lm2-poly/PCF_Setup_Article/BOM_Article.xlsx

Name | Description | Number | Unity price | Total price | Link
Sub-assembly: Flowmeter group
Rosemount 8711TSA010T1N0 flowmeter | Magnetic flowtube salvaged on an older experimental setup. Any other flowtube can work as well depending on your setup scale and precision needs | 1 | 2200 | 2200 | See with your local Rosemount products supplier
Rosemount 8732CT12N0M4 transmitter | Transmitter assembled with the flowtube to read the flowrate and give an output current signal from 4 to 20mA. Any alternative compatible with your flowtube can be considered | 1 | 2800 | 2800 | See with your local Rosemount products supplier
Steel corner brackets 1845A34 | Steel corners to be machined to fix the flowmeter on the wall | 2 | 30.03 | 60.06 | https://www.mcmaster.com/1845A34/
Threaded rods 96545A235 | Threaded rods used to fix the flowmeter between the flanges | 4 | 9.58 | 38.32 | https://www.mcmaster.com/96545A235/
Washers 98017A215 | Washers used to fix the flowmeter between the flanges (pack of 25) | 1 | 17.37 | 17.37 | https://www.mcmaster.com/98017A215/
Nuts 95462A533 | Nuts used to fix the flowmeter between the flanges (pack of 25) | 1 | 14.26 | 14.26 | https://www.mcmaster.com/95462A533/
Flange 43505K353 | Flange used to fix the flowmeter | 2 | 48.65 | 97.3 | https://www.mcmaster.com/43505K353/
Rubber gasket 1082N11 | Gasket used between the flowmeter and the flanges to achieve sealing | 2 | 2.06 | 4.12 | https://www.mcmaster.com/1082N11/
Barbed fitting 5361K46 | Barbed fitting used to connect the flowmeter to the flexible hoses of the circuit | 2 | 26.4 | 52.8 | https://www.mcmaster.com/5361K46/
Sub-assembly: Secondary tank
Secondary tank 3669K27 | Pressure rated tank used to attenuate fluctuation in the flow after the pump | 1 | 381.4 | 381.4 | https://www.mcmaster.com/3669K27/
Heavy shelf brackets 2736A723 | Brackets used to support the tank on the wall | 2 | 18.84 | 37.68 | https://www.mcmaster.com/2736A723/
Clamp 3116T75 | Clamp used to maintain the tank to the wall | 1 | 234.26 | 234.26 | https://www.mcmaster.com/3116T75/
Wood plank 1125T421 | Wood plank used to support the tank on the shelf brackets | 1 | 50.83 | 50.83 | https://www.mcmaster.com/1125T421/
Pressure relieve valve 4780K13-4780K86 | Relieve valve to avoid pressures above 75psi in the circuit | 1 | 165.23 | 165.23 | https://www.mcmaster.com/4780K13-4780K86/
Barbed fitting 5361K46 | Barbed fitting used to connect the secondary tank to the flexible hoses of the circuit | 2 | 26.4 | 52.8 | https://www.mcmaster.com/5361K46/
Plug 1" 4464K256 | Plug used to block the unused outputs/inputs of the secondary tank | 2 | 10.54 | 21.08 | https://www.mcmaster.com/4464K256/
Plug 1 1/4" 4464K257 | Plug used to block the unused outputs/inputs of the secondary tank | 1 | 17.06 | 17.06 | https://www.mcmaster.com/4464K257/
Plug 1/2" 4464K254 | Plug used to block the unused outputs/inputs of the secondary tank | 1 | 4.88 | 4.88 | https://www.mcmaster.com/4464K254/
Screws 92949A251 | Screws used for the fixation of the wood plank on the brackets (pack of 50) | 1 | 11.59 | 11.59 | https://www.mcmaster.com/92949A251/
Washers 92141A011 | Washers used for the fixation of the wood plank on the brackets (pack of 100) | 1 | 2.4 | 2.4 | https://www.mcmaster.com/92141A011/
Nuts 91841A011 | Nuts used for the fixation of the wood plank on the brackets (pack of 100) | 1 | 5.35 | 5.35 | https://www.mcmaster.com/91841A011/
Sub-assembly: Pump group
Baldor M3559 motor | 3HP, 3450RPM, 60Hz, 208-230V single phase motor used to drive the pump. This motor was salvaged on an old experimental setup and is not sold anymore. Any alternative providing enough power for the needed flowrate and compatible with the reader electrical instalation and pump is to be considered | 1 | NA | NA | https://www.baldor.com/catalog/M3559
Price Pump Model OH75 | Centrifugal pump mounted on the Baldor motor. This pump is also not in sale anymore and the reader can chose any pump corresponding to his needs and compatible with its motor | 1 | NA | NA | https://www.price-pumpen.de/oh75-series.html
Siemens Sinamics V20 drive | Electrical drive used to control the motor of the pump. This drive was chosen to correspond to our motor and our electrical installation. The reader shall chose his trio motor, pump and drive | 1 | 380 | 380 | See with your local Siemens supplier
Union connector 4464K487 | Union threaded connector used to disconnect the output of the pump easily | 1 | 23.7 | 23.7 | https://www.mcmaster.com/4464K487/
Union connector 4464K488 | Union threaded connector used to disconnect the input of the pump easily | 1 | 35.66 | 35.66 | https://www.mcmaster.com/4464K488/
Stainless steel pipe 4830K196 | Pipe used to connect the output of the pump to the flow control valve | 1 | 10.11 | 10.11 | https://www.mcmaster.com/4830K196/
Flow control valve 4742K14 | Valve added at the output of the pump to control the flowrate more precisely if needed | 1 | 92.75 | 92.75 | https://www.mcmaster.com/4742K14/
Barbe fitting 5361K45 | Barbed fitting used to connect the output of the pump to the flexible hoses of the circuit | 1 | 16.24 | 16.24 | https://www.mcmaster.com/5361K45/
Barbe fitting 5361K48 | Barbed fitting used to connect the input of the pump to the flexible hoses of the circuit | 1 | 23.84 | 23.84 | https://www.mcmaster.com/5361K48/
Sub-assembly: Main tank
Main plastic tank 3764K31 | Main 30USG plastic tank used to store the water of the system | 1 | 690 | 690 | https://www.mcmaster.com/3764K31/
Plastic pipe 9173K75 | Pipe connected to the output of the main tank | 1 | 4.96 | 4.96 | https://www.mcmaster.com/9173K75/
Plastic to stainless steel pipe adapter 4596K287 | Part used to connect the plastic part of the tank to the stainless circuit | 1 | 222.27 | 222.27 | https://www.mcmaster.com/4596K287/
Stainless steel pipe 4830K226 | Pipe connected to the output of the main tank before the On/Off valve | 1 | 13.32 | 13.32 | https://www.mcmaster.com/4830K226/
On/Off valve 4629K15 | Valve after the tank to close the ouput of the tank if needed | 1 | 33.8 | 33.8 | https://www.mcmaster.com/4629K15/
Barbe fitting 5361K48 | Barbed fitting used to connect the output of the main tank to the flexible hoses of the circuit | 1 | 23.84 | 23.84 | https://www.mcmaster.com/5361K48/
Sub-assembly: Acrylic tank
Wall acrylic sheets 8560K435 | Translucid side plates of the tank | 4 | 105.64 | 422.56 | https://www.mcmaster.com/8560K435/
Bottom acrylic sheet 8560K272 | Bottom plate of the tank | 1 | 354.97 | 354.97 | https://www.mcmaster.com/8560K272/
Bottom wood plank 1125T614 | Wood plank added to the acrylic bottom sheet to improve rigidity and facilitate assembly of the tank | 1 | 54.15 | 54.15 | https://www.mcmaster.com/1125T614/
Middle drain 36895K156 | Drain in the middle of the tank to evacuate the water coming from the pipe conveying fluid | 1 | 74.7 | 74.7 | https://www.mcmaster.com/36895K156/
Corner aluminium part 8144A33 | Corners fixed on each corner of the acrylic tank to improve rigidity and avoid leaks. The parts have to be cut in half to have the 2 feets hight of the tank | 2 | 55.12 | 110.24 | https://www.mcmaster.com/8144A33/
Sub-assembly: Acrylic tank support
Aluminium T-slotted extrusion 47065T102-47065T602 | Aluminium extrusions used to build the structure to support the acrylic tank | 14 | 27.58 | 386.12 | https://www.mcmaster.com/47065T102-47065T602/
Corner fixations 47065T241 | Corners used to fix the extrusions together (sold with screws) | 20 | 9.54 | 190.8 | https://www.mcmaster.com/47065T241/
Floor mounting 3136N146 | Mountings used to fix the extrusions on the floor of the lab (sold with screws) | 4 | 63.97 | 255.88 | https://www.mcmaster.com/3136N146/
Sub-assembly: Pipes from the acrylic to the main tank and tubing
PVC Pipe 4882K88 | Plastic pipe connected to the drain of the acrylic tank | 1 | 15.07 | 15.07 | https://www.mcmaster.com/4882K88/
PVC elbows 4880K174 | Plastic elbows used for the tubing between the acrylic tank and the main tank | 2 | 16.48 | 32.96 | https://www.mcmaster.com/4880K174/
PVC Pipe 6810K618 | Plastic pipe used for the tubing between the acrylic tank and the main tank | 1 | 66.67 | 66.67 | https://www.mcmaster.com/6810K618/
PVC Pipe 6810K47 | Plastic pipe used for the tubing between the acrylic tank and the main tank | 1 | 37.01 | 37.01 | https://www.mcmaster.com/6810K47/
On/Off valve 2772T95 | Valve used to close the output of the acrylic tank | 1 | 24.42 | 24.42 | https://www.mcmaster.com/2772T95/
Strut channel 3188T3-3188T23 | Structure fixed to the wall and used to maintain the piping between the acrylic tank and the main tank | 1 | 25.56 | 25.56 | https://www.mcmaster.com/3188T3-3188T23/
Pipe clamp 3006T83 | Hanging pipe clamp fixed on the previous strut channel to clamp the pipe from the acrylic tank to the main tank | 1 | 27.96 | 27.96 | https://www.mcmaster.com/3006T83/
Flexible hose 5632K36 | 3/4" and 5ft long hoses used to connect the secondary tank to the flowmeter and the flowmeter to the pipe conveying fluid | 2 | 9.8 | 19.6 | https://www.mcmaster.com/5632K36/
Flexible hose 5632K36 | 3/4" and 10ft long hose used to connect the output of the pump to the secondary tank | 1 | 15.6 | 15.6 | https://www.mcmaster.com/5632K36/
Flexible hose 52375K17 | 1" and 5ft long hose used to connect the main tank to the input of the pump | 1 | 18.05 | 18.05 | https://www.mcmaster.com/52375K17/
Worm drive clamp 5388K16 | Worm drive clamp used to clamp the pipe conveying fluid on the barbe fitting (pack of 10) | 1 | 10.02 | 10.02 | https://www.mcmaster.com/5388K16/
Worm drive clamp 5388K22 | Worm drive clamp used to clamp the 1" flexible hoses on the barbe fittings (pack of 10) | 1 | 12.57 | 12.57 | https://www.mcmaster.com/5388K22/
Worm drive clamp 5388K17 | Worm drive clamp used to clamp the 3/4" flexible hoses on the barbe fittings (pack of 10) | 1 | 11 | 11 | https://www.mcmaster.com/5388K17/
Sub-assembly: Cameras
BFS-U3-20S4C-C Camera | USB3 cameras used to film the pipe from 2 directions at relatively high FPS | 2 | 825 | 1650 | See with your local camera supplier
FL-CC0814-2M Lens | 6mm lenses mounted on the cameras | 2 | 135 | 270 | See with your local camera supplier
ACC-01-2301 USB cable | Cables used to connect the cameras to a laptop | 2 | 33 | 66 | See with your local camera supplier
ACC-01-3009 GPIO cable | GPIO cables used to control (synchronize) the cameras with voltage signals | 2 | 38 | 76 | See with your local camera supplier
ACC-01-0016 mounting plate | Tripod mounting plate used to fix the cameras | 2 | 33 | 66 | See with your local camera supplier
Aluminium T-Slotted extrusion 47065T101-47065T412 | Aluminium rails used to fix the camera and to be able to adjust their positions in 2 dimensions | 2 | 16.65 | 33.3 | https://www.mcmaster.com/47065T101-47065T412/
Corner brackets 2313N47 | Corner screwed on the rails to support the cameras | 2 | 13.39 | 26.78 | https://www.mcmaster.com/2313N47/
Corner fixations 47065T236 | Corner used to fix the 3D printed parts on the aluminium extrusions (sold with screws) | 10 | 7.92 | 79.2 | https://www.mcmaster.com/47065T236/
Screws 91290A195 | Screws used to fix the previous corners on the 3D printed parts (pack of 10) | 1 | 7.67 | 7.67 | https://www.mcmaster.com/91290A195/
Nuts 90591A260 | Nuts used to fix the previous corners on the 3D printed parts (pack of 100) | 1 | 3.56 | 3.56 | https://www.mcmaster.com/90591A260/
Washers 93475A240 | Washers used to fix the previous corners on the 3D printed parts (pack of 100) | 1 | 3.52 | 3.52 | https://www.mcmaster.com/93475A240/
T-slot nuts 94750A591 | Nuts used to clamp the bottom 3D printed parts on the bottom edge of the tank | 4 | 8.16 | 32.64 | https://www.mcmaster.com/94750A591/
Screws 91251A846 | Screws used to clamp the bottom edge of the tank with the previous T-slotted nuts | 4 | 4.8 | 19.2 | https://www.mcmaster.com/91251A846/
Top 3D printed part CameraFixTop | 3D printed part clamped on the top of the acylic tank and maintaining the aluminium T-slotted extrusion | 2 | NA | NA | See the design files summary
Bottom 3D printed part CameraFixBot | 3D printed part clamped on the bottom edge of the acylic tank and maintaining the aluminium T-slotted extrusion | 2 | NA | NA | See the design files summary
T-slotted inserts fixations 47065T215 | Fixations used to fix the cameras corners to the aluminium T-slotted rails (pack of 4) | 1 | 3.56 | 3.56 | https://www.mcmaster.com/47065T215/
Sub-assembly: Pipe conveying fluid and flowstraightener fixation
Wall mounting 3136N146 | Mountings used to fix the extrusions on the wall of the lab (sold with screws) | 2 | 63.97 | 127.94 | https://www.mcmaster.com/3136N146/
Corners fixations 3136N179 | Corners used to fix the extrusions together or to the wall (sold with screws) | 12 | 11.26 | 135.12 | https://www.mcmaster.com/3136N179/
Corners fixations 47065T309 | Corners plates used to fix the extrusions together with a 45 degrees angle (sold with screws) | 2 | 18.25 | 36.5 | https://www.mcmaster.com/47065T309/
Mounting plate 47065T854 | Plate used to fix the bottom 3D printed part to the extrusion structure (sold with screws) | 2 | 14.56 | 29.12 | https://www.mcmaster.com/47065T854/
Aluminium T-slotted extrusion 47065T102-47065T601 | Aluminium 1ft long extrusions used to fix the structure on the wall | 4 | 9.81 | 39.24 | https://www.mcmaster.com/47065T102-47065T601/
Aluminium T-slotted extrusion 47065T704 | Aluminium 2ft long extrusions with 45 degrees bizot used to fix the pipe conveying fluid and the flowstraightener (sold with screws) | 6 | 40.77 | 244.62 | https://www.mcmaster.com/47065T704/
Aluminium T-slotted extrusion 47065T102-47065T144 | Aluminium 2ft long extrusions used to fix the pipe conveying fluid and the flowstraightener | 2 | 18.38 | 36.76 | https://www.mcmaster.com/47065T102-47065T144/
Barbe fitting 5361K45 | Barbed fitting used to connect the flowstraightener to the flexible hoses of the circuit | 1 | 16.24 | 16.24 | https://www.mcmaster.com/5361K45/
Pipe reducer 4464K454 | Pipe reducer from 3/4" to 2" used to connect the 2" pipe from the flowstraightener | 1 | 103.58 | 103.58 | https://www.mcmaster.com/4464K454/
Stainless steel pipe 4830K289 | Pipe stuffed with straws to build a flowstraightener | 1 | 39.56 | 39.56 | https://www.mcmaster.com/4830K289/
Pipe reducer 4452K647 | Pipe reducer from 1/2" to 2" used to connect the 2" pipe from the flowstraightener to the barbe fitting from the pipe conveying fluid | 1 | 77.49 | 77.49 | https://www.mcmaster.com/4452K647/
Top 3D printed part PipeFixTop | 3D printed part used to fix the top of the flowstraightener to the extrusions structure | 1 | NA | NA | See the design files summary
Bottom 3D printed part PipeFixBot | 3D printed part used to fix the bottom of the flowstraightener to the extrusions structure | 1 | NA | NA | See the design files summary
Barbe fitting 5361K84 | Barbe fitting used to connect the pipe conveying fluid to the circuit | 1 | 13.99 | 13.99 | https://www.mcmaster.com/5361K84/
Helical inserts kit 91732A948 | Helical inserts kit used to create threaded holes in the two 3D printed parts | 1 | 50.47 | 50.47 | https://www.mcmaster.com/91732A948/
Screws 95263A516 | Screws used with the helical inserts to fix the 3D printed parts to the extrusion structures | 1 | 7.33 | 7.33 | https://www.mcmaster.com/95263A516/
Sub-assembly: Aquisition system
NI 9203 | Analogic current aquisition card used to retrieve the flowrate value from the flowmeter | 1 | 900 | 900 | See with your local NI supplier
NI 9263 | Analogic voltage output card used to synchonyze the 2 cameras | 1 | 750 | 750 | See with your local NI supplier
NI cDAQ 9174 | Cards chassis used to fix and connect the cards to the laptop | 1 | 1420 | 1420 | See with your local NI supplier
NI 9977 | Blank cards used to fill the empty slots of the chassis | 2 | 60 | 120 | See with your local NI supplier
Shielded cable 8219K68 | Shielded cable used to connect the flowmeter to the aquisition card | 1 | 4.81 | 4.81 | https://www.mcmaster.com/8219K68/
Sub-assembly: Mould
Threaded rods 98847A011 | Threaded rods used to tighten the two 3D printed parts together | 4 | 4.52 | 18.08 | https://www.mcmaster.com/98847A011/
Nuts 91841A011 | Nuts used to tighten the two 3D printed parts together (pack of 100) | 1 | 5.35 | 5.35 | https://www.mcmaster.com/91841A011/
Washers 90107A011 | Washers used to tighten the two 3D printed parts together (pack of 100) | 1 | 5.11 | 5.11 | https://www.mcmaster.com/90107A011/
Plastic washer 94639A255 | Plastic washers used to center the stainless steel center rod (pack of 10) | 1 | 2.81 | 2.81 | https://www.mcmaster.com/94639A255/
Syringes 7510A808 | Syringes used to inject the rubber silicon mix into the mould | 3 | 6.74 | 20.22 | https://www.mcmaster.com/7510A808/
Dowel pins 98381A544 | Dowel pins used to guarantee the alignments of the two aluminium parts of the mould (pack of 25) | 1 | 8.2 | 8.2 | https://www.mcmaster.com/98381A544/
Screws 91290A173 | Screws used to tighten the two aluminium parts of the mould (pack of 5) | 3 | 3.88 | 11.64 | https://www.mcmaster.com/91290A173/
Mixing sticks 7632A11 | Sticks used to mix the two parts of the rubber silicon (pack of 12) | 1 | 4.03 | 4.03 | https://www.mcmaster.com/7632A11/
Center rod 8934K26-8934K263 | 2ft long stainless steel rod used to create the center hole of the pipe | 1 | 18.89 | 18.89 | https://www.mcmaster.com/8934K26-8934K263/
Mixing cup 2084N11 | Cups used to mix the rubber silicon components | 1 | 0.85 | 0.85 | https://www.mcmaster.com/2084N11/
Reamer 3106A24 | Reamer used to drill the hole in which the dowel pins will go | 1 | 25.17 | 25.17 | https://www.mcmaster.com/3106A24/
Drill bit 30595A33 | Drill bit used to drill the holes for the dowels pins and the screws in the mould | 1 | 3.36 | 3.36 | https://www.mcmaster.com/30595A33/
Drill bit 8950A15 | Drill bit used to drill the holes for the dowels pins and the screws in the mould | 1 | 3.66 | 3.66 | https://www.mcmaster.com/8950A15/
Hole starting drill bit 2911A29 | Drill bit used to mark the entry point of the holes | 1 | 20.76 | 20.76 | https://www.mcmaster.com/2911A29/
Tap set 8305A519 | Tap set used to create threaded holes in the aluminium mould part | 1 | 20.82 | 20.82 | https://www.mcmaster.com/8305A519/
Ball end mill 3046A19 | Mill used to create the two aluminium parts of the mould with the 3 axis milling machine | 1 | 54.89 | 54.89 | https://www.mcmaster.com/3046A19/
Flat end mill 2716A31 | Mill used to create the two aluminium parts of the mould with the 3 axis milling machine | 1 | 28.23 | 28.23 | https://www.mcmaster.com/2716A31/
OOMOO30 rubber-silicon | Rubber silicon mix used to create the pipe | 1 | 45 | 45 | https://www.smooth-on.com/products/oomoo-30/
Black pigments for rubber-silicon | Pigments added to the rubber silicon to obtain a black pipe | 1 | 20 | 20 | https://www.smooth-on.com/products/silc-pig/
Aluminium bars 8975K253-8975K998 | Aluminium bars from which the parts of the mould are created | 2 | 75.09 | 150.18 | https://www.mcmaster.com/8975K253-8975K998/
3D printed caps of the mould MouldCapPLA | 3D printed parts used to close both ends of the mould | 2 | NA | NA | See the design files summary
Total price |  |  |  | 16962.64
