lm2-poly/PCF_Setup_Article/Design_files/PipeFixTop.stp

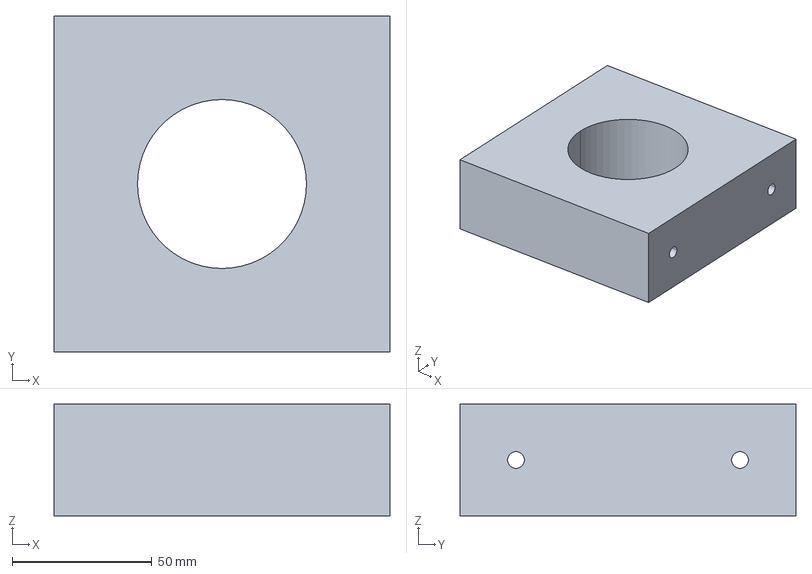
[picture p1: CAD file, 2023-03-09]
Design_files/PipeFixTop.stp
120.0 x 120.0 x 40.0 mm
