lm2-poly/PCF_Setup_Article/Design_files/PipeFixBot.stp

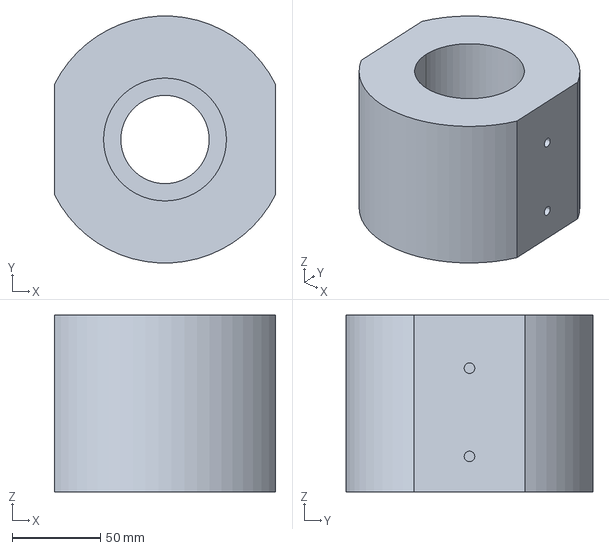
[picture p2: CAD file, 2023-03-09]
Design_files/PipeFixBot.stp
125.2 x 139.8 x 100.0 mm
