lm2-poly/PCF_Setup_Article/Design_files/MouldBotAlu.stp

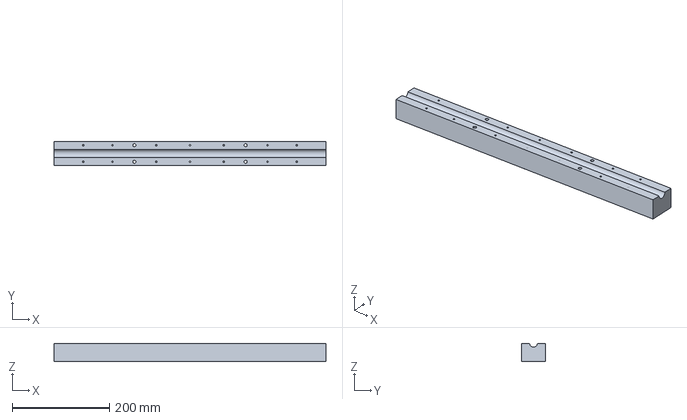
[picture p3: CAD file, 2023-03-09]
Design_files/MouldBotAlu.stp
558.8 x 50.0 x 38.0 mm
