lm2-poly/PCF_Setup_Article/Design_files/MouldTopAlu.stp

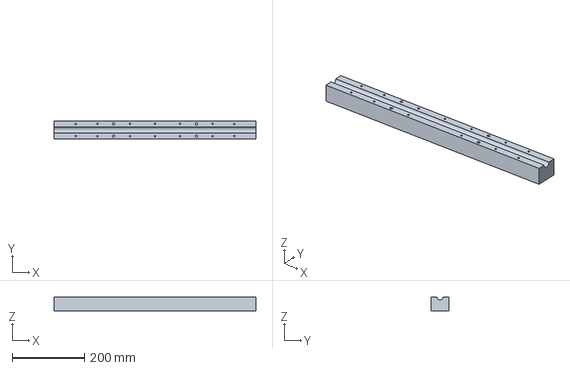
[picture p4: CAD file, 2023-03-09]
Design_files/MouldTopAlu.stp
558.8 x 50.0 x 38.0 mm
