lm2-poly/PCF_Setup_Article/Design_files/CameraFixTop.stp

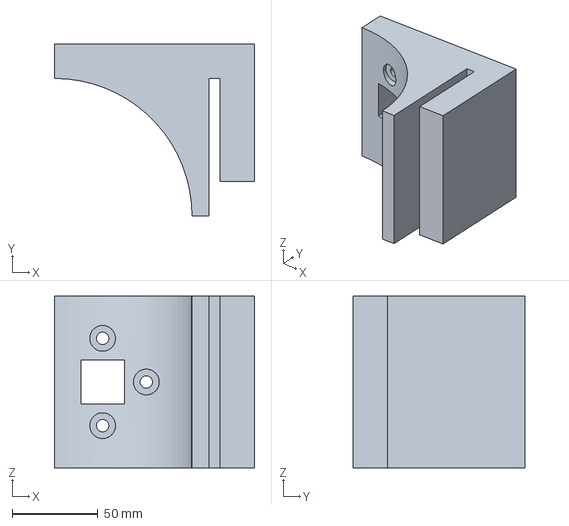
[picture p5: CAD file, 2023-03-09]
Design_files/CameraFixTop.stp
116.3 x 100.0 x 100.0 mm
