lm2-poly/PCF_Setup_Article/Design_files/MouldCapPLA.stp

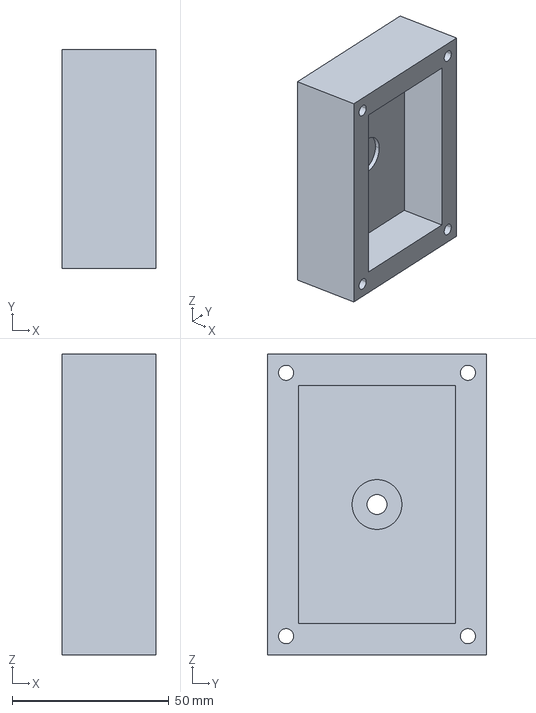
[picture p6: CAD file, 2023-03-09]
Design_files/MouldCapPLA.stp
30.0 x 70.0 x 96.0 mm
