lm2-poly/PCF_Setup_Article/Design_files/CameraFixBot.stp

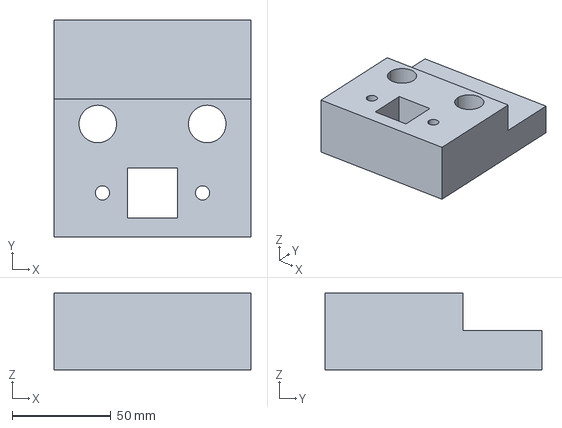
[picture p7: CAD file, 2023-03-09]
Design_files/CameraFixBot.stp
100.0 x 110.0 x 39.0 mm
